DMontgomery40/openframe_printer/docs/25_open_consumables_spec.md

# 25. Open consumables spec

OpenFrame consumables are designed to be honest parts, not hostage mechanisms.

## Cartridge rules

- No cryptographic lockout.
- No cloud validation.
- No refusal to print because a cartridge is third-party.
- A resistor ID is allowed only to communicate cartridge family or capacity.
- User must be able to override non-safety warnings.
- Safety faults still stop printing.

## Toner container starting target

| Parameter | Value |
|---|---:|
| Toner mass | 80 g |
| Toner particle size | 6-8 µm |
| Dense black laydown model | 0.55 mg/cm² |
| Office coverage assumption | 5% |
| Naive theoretical pages (every gram on paper) | about 4800 pages |
| Rated pages, loss-adjusted (90% transfer, 8% hopper residual) | about 4000 pages |

The rated figure is generated by `openframe_printer/toner_budget.py` into `out/v2_toner_mass_balance.json`; the same artifact sizes the cartridge waste cavity (about 28 cm³ with margin) and derives the pixel-count gauge constant. A previous revision of this table stated a 2400-page figure that no model in the package ever produced; it is retired and the smoke test keeps it out.

## Toner level gauge without DRM

The printer estimates remaining toner by counting developed black pixels (about 11 mg per million black pixels at nominal laydown) instead of reading a lockout chip. The estimate carries ±20% error until density calibration runs, is displayed as a warning and ordering hint only, and never stops printing.

## Replacement parts

| Part | Sold directly | User replaceable | Service replaceable |
|---|---:|---:|---:|
| Toner/process cartridge | yes | yes | yes |
| Drum submodule | yes | yes | yes |
| Pickup roller kit | yes | yes | yes |
| Separation pad | yes | yes | yes |
| Transfer roller | yes | yes | yes |
| Fuser module | yes | no | yes |
| HV module | yes | no | yes |
| LED bar | yes | no | yes |
| Controller board | yes | no | yes |
| PSU | yes | no | yes |

## Service data exposed in UI

- Page count by module.
- Jam counts by sensor.
- Fuser warm-up time history.
- HV monitor values during calibration.
- Density calibration table.
- Firmware version.
- Last 50 fault events.
- Consumable warnings as warnings, not lockouts.
