DMontgomery40/openframe_printer/docs/04_mechanics_paper_path.md

# 04. Mechanics and paper path

This file is superseded by `docs/21_paper_path_geometry_revA.md` for v2 numeric values.

## Rev A station map

| Station | Y position |
|---|---:|
| Tray leading-edge home | 0 mm |
| Pickup nip | 25 mm |
| Separation nip | 32 mm |
| Pre-registration sensor | 88 mm |
| Registration nip | 112 mm |
| Image sync sensor | 138 mm |
| Transfer nip | 180 mm |
| Fuser entry | 255 mm |
| Fuser exit | 285 mm |
| Exit sensor | 340 mm |
| Output roller | 360 mm |

## Rev A roller diameters

| Roller | Diameter |
|---|---:|
| Pickup | 18 mm |
| Registration | 12 mm |
| OPC drum | 30 mm |
| Primary charge roller | 10 mm |
| Developer roller | 16 mm |
| Transfer roller | 14 mm |
| Fuser hot roller | 24 mm |
| Fuser pressure roller | 24 mm |
| Exit roller | 16 mm |

The first physical rig is cold paper motion only. No HV, no fuser heat, no LED output, no toner.
