DMontgomery40/openframe_printer/(commit log)

2026-07-06 chore: re-baseline repo at Rev D (verified)
    Previous local history (Rev A import + Step 2/3/4 commits) was lost when
    the Rev D package was overlaid without .git. This commit re-baselines at
    Rev D: v2 design report engines (hv_model, dev_probe, transfer_model,
    station map, voltage ladder, PIDC), retired Rev A -720 V PCR target,
    28-test model suite, updated docs/RFQs/firmware.
    Verified locally: design_report + smoke_test OK, model_tests 28/28 OK,
    firmware syntax-checked.
    Claude-Session: https://claude.ai/code/session_01Ch9VefGYre4Jh9PKdGoC36
    [control_board_pinmap.csv, hv_bias_targets.csv, inkjet_nozzle_design_space.csv, ofp_m1_revA_connectors.csv, ofp_m1_revA_hv_bias_channels.csv, ofp_m1_revA_interlock_matrix.csv, ofp_m1_revA_motor_map.csv, ofp_m1_revA_netlist.tsv]
2026-07-06 feat: Rev E — OFP1 protocol, interlock fault analysis, EP halftoning, toner mass balance
    Four subsystems no revision had modeled:
    - ofp1.py: the OFP1 protocol named since v1 is now defined — CRC-16 framing,
    SKIP compression, reference encoder/decoder with bit-exact round-trip and
    corruption NACK. Transport budget: worst-case page is 78% of the USB FS
    bulk ceiling; production spec is USB HS.
    - interlock_faults.py: exhaustive stuck-at enumeration with adversarial
    firmware. Documented chain has 7 single-point failures; Rev E dual-chain
    topology has zero (proven, gated).
    - halftone.py: 2x2-seeded clustered screen emits zero isolated 42 um pixels
    at any tone; Bayer/error-diffusio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
2026-07-06 chore(license): switch to PolyForm Noncommercial 1.0.0
    Source-available, noncommercial-use license, replacing MIT. No
    copyleft-encumbered dependencies in this repo (pure-Python design
    package, no vendored SDK), so the switch is a clean, unconstrained
    choice rather than one forced by a dependency.
    Claude-Session: https://claude.ai/code/session_014EhyihFzpk1BbDT8wKL5Hv
2026-07-06 feat: Rev F/G — halftone floor gate, common-cause interlock fault, fuser/erase/HV/emissions/registration budgets
    Rev F: clips sub-floor halftone seeds below the declared 4/64 highlight
    floor, adds a shared door-actuator common-cause interlock fault
    topology, retires the unqualified toner-yield figure, and adds fuser
    power balance and LED thermal feed-forward.
    Rev G: gates clutch start on OFP1 decoded-buffer margin (USB FS
    sustains only 12 ppm worst-case), requires encoder-slaved line timing
    for motion registration, adds a supplier MTF/spot-size optical gate,
    an independent-thermostat/thermal-fuse fuser safety path with zero
    modeled single-fault violations, a post-cleaning erase/quench sta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
    [ofp_m1_revF_interlock_delta.csv, ofp_m1_revG_fuser_safety_delta.csv, ofp_m1_revG_ledbar_optical_acceptance.csv, ofp_m1_revG_motion_encoder_delta.csv, ofp_m1_revG_process_safety_delta.csv, ofp_m1_revG_transport_delta.csv]
